MihailJP/AudioMeter/sqrttable.ino

#include "sqrttable.h"

#ifdef USE_SQRT_TABLE
const unsigned short sqrtTable[3072] = {
  0x0000, 0x001f, 0x003f, 0x005f, 0x007f, 0x009f, 0x00bf, 0x00df,  0x00ff, 0x011f, 0x013f, 0x015f, 0x017e, 0x019e, 0x01be, 0x01de,
  0x01fe, 0x021d, 0x023d, 0x025d, 0x027c, 0x029c, 0x02bc, 0x02db,  0x02fb, 0x031b, 0x033a, 0x035a, 0x0379, 0x0399, 0x03b9, 0x03d8,
  0x03f8, 0x0417, 0x0437, 0x0456, 0x0476, 0x0495, 0x04b4, 0x04d4,  0x04f3, 0x0513, 0x0532, 0x0551, 0x0571, 0x0590, 0x05af, 0x05cf,
  0x05ee, 0x060d, 0x062c, 0x064c, 0x066b, 0x068a, 0x06a9, 0x06c8,  0x06e8, 0x0707, 0x0726, 0x0745, 0x0764, 0x0783, 0x07a2, 0x07c1,
  0x07e0, 0x0800, 0x081f, 0x083e, 0x085d, 0x087c, 0x089a, 0x08b9,  0x08d8, 0x08f7, 0x0916, 0x0935, 0x0954, 0x0973, 0x0992, 0x09b1,
  0x09cf, 0x09ee, 0x0a0d, 0x0a2c, 0x0a4b, 0x0a69, 0x0a88, 0x0aa7,  0x0ac5, 0x0ae4, 0x0b03, 0x0b22, 0x0b40, 0x0b5f, 0x0b7d, 0x0b9c,
  0x0bbb, 0x0bd9, 0x0bf8, 0x0c16, 0x0c35, 0x0c54, 0x0c72, 0x0c91,  0x0caf, 0x0cce, 0x0cec, 0x0d0a, 0x0d29, 0x0d47, 0x0d66, 0x0d84,
  0x0da3, 0x0dc1, 0x0ddf, 0x0dfe, 0x0e1c, 0x0e3a, 0x0e59, 0x0e77,  0x0e95, 0x0eb3, 0x0ed2, 0x0ef0, 0x0f0e, 0x0f2c, 0x0f4b, 0x0f69,
  0x0f87, 0x0fa5, 0x0fc3, 0x0fe1, 0x1000, 0x101e, 0x103c, 0x105a,  0x1078, 0x1096, 0x10b4, 0x10d2, 0x10f0, 0x110e, 0x112c, 0x114a,
  0x1168, 0x1186, 0x11a4, 0x11c2, 0x11e0, 0x11fe, 0x121c, 0x1239,  0x1257, 0x1275, 0x1293, 0x12b1, 0x12cf, 0x12ec, 0x130a, 0x1328,
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
  0x432f, 0x4348, 0x4361, 0x437b, 0x4394, 0x43ad, 0x43c7, 0x43e0,  0x43f9, 0x4412, 0x442c, 0x4445, 0x445e, 0x4478, 0x4491, 0x44aa,
  0x44c3, 0x44dc, 0x44f6, 0x450f, 0x4528, 0x4541, 0x455a, 0x4574,  0x458d, 0x45a6, 0x45bf, 0x45d8, 0x45f1, 0x460a, 0x4624, 0x463d,
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
  };
#endif /* USE_SQRT_TABLE */
