MihailJP/AudioMeter/logtable.ino

#include "logtable.h"

#ifdef USE_LOG_TABLE
const unsigned short logTable[4096] = {
  0x000, 0x001, 0x002, 0x004, 0x005, 0x007, 0x008, 0x00a,  0x00b, 0x00c, 0x00e, 0x00f, 0x011, 0x012, 0x014, 0x015,
  0x017, 0x018, 0x019, 0x01b, 0x01c, 0x01e, 0x01f, 0x021,  0x022, 0x023, 0x025, 0x026, 0x028, 0x029, 0x02b, 0x02c,
  0x02d, 0x02f, 0x030, 0x032, 0x033, 0x035, 0x036, 0x037,  0x039, 0x03a, 0x03c, 0x03d, 0x03f, 0x040, 0x041, 0x043,
  0x044, 0x046, 0x047, 0x049, 0x04a, 0x04b, 0x04d, 0x04e,  0x050, 0x051, 0x053, 0x054, 0x055, 0x057, 0x058, 0x05a,
  0x05b, 0x05d, 0x05e, 0x05f, 0x061, 0x062, 0x064, 0x065,  0x066, 0x068, 0x069, 0x06b, 0x06c, 0x06e, 0x06f, 0x070,
  0x072, 0x073, 0x075, 0x076, 0x077, 0x079, 0x07a, 0x07c,  0x07d, 0x07f, 0x080, 0x081, 0x083, 0x084, 0x086, 0x087,
  0x088, 0x08a, 0x08b, 0x08d, 0x08e, 0x08f, 0x091, 0x092,  0x094, 0x095, 0x096, 0x098, 0x099, 0x09b, 0x09c, 0x09e,
  0x09f, 0x0a0, 0x0a2, 0x0a3, 0x0a5, 0x0a6, 0x0a7, 0x0a9,  0x0aa, 0x0ac, 0x0ad, 0x0ae, 0x0b0, 0x0b1, 0x0b3, 0x0b4,
  0x0b5, 0x0b7, 0x0b8, 0x0ba, 0x0bb, 0x0bc, 0x0be, 0x0bf,  0x0c1, 0x0c2, 0x0c3, 0x0c5, 0x0c6, 0x0c7, 0x0c9, 0x0ca,
  0x0cc, 0x0cd, 0x0ce, 0x0d0, 0x0d1, 0x0d3, 0x0d4, 0x0d5,  0x0d7, 0x0d8, 0x0da, 0x0db, 0x0dc, 0x0de, 0x0df, 0x0e1,
  0x0e2, 0x0e3, 0x0e5, 0x0e6, 0x0e7, 0x0e9, 0x0ea, 0x0ec,  0x0ed, 0x0ee, 0x0f0, 0x0f1, 0x0f3, 0x0f4, 0x0f5, 0x0f7,
  0x0f8, 0x0f9, 0x0fb, 0x0fc, 0x0fe, 0x0ff, 0x100, 0x102,  0x103, 0x105, 0x106, 0x107, 0x109, 0x10a, 0x10b, 0x10d,
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
  0x331, 0x333, 0x334, 0x335, 0x336, 0x338, 0x339, 0x33a,  0x33b, 0x33d, 0x33e, 0x33f, 0x340, 0x342, 0x343, 0x344,
  0x345, 0x347, 0x348, 0x349, 0x34a, 0x34c, 0x34d, 0x34e,  0x34f, 0x351, 0x352, 0x353, 0x354, 0x356, 0x357, 0x358,
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
};
#endif /* USE_LOG_TABLE */
