MihailJP/AudioMeter/(commit log)

2016-07-28 Add sampler
2016-07-28 Add timer
2016-07-28 SPI bit rate
2016-07-28 Class for fixed point arithmetic
    [fixed.h, fixed.ino]
2016-07-28 Validity flag in Fixed class
    [fixed.h, fixed.ino]
2016-07-28 Fixed::sqrt()
    Square root by algorithm as in Odhner machine
    [fixed.h, fixed.ino]
2016-07-28 Use fixed point for bar graph
    [bargraph.h, bargraph.ino]
2016-07-28 Thin samples out from Lissajous plot
2016-07-30 Fixed bar graph over-/underflow issue
    [bargraph.ino]
2016-07-30 Revert "Remove prescaler"
    This reverts commit ccf33b6d494ef5e43faf04e26794629bf7718447.
    [lissajous.h, lissajous.ino]
2016-07-31 Condensed data storage
    5 samples, rather than 4, per 64 bit
2016-08-01 Add Screen::print()
2016-08-01 Fix too long peak hold
    [bargraph.h]
